Minki-Choi6-fm/2026ESWContest_mobility_AIV/(notices)

Notices in the files:
rear-pi5/firmware/stm32_rear/main_v18d2_final_proposed.c:
Copyright (c) 2026 STMicroelectronics.
All rights reserved.
This software is licensed under terms that can be found in the LICENSE file
